ChiragCR13/Open-Loop-Boost-Converter/LTSpice/BoostConverter.asc

A1: schmitt; vt=4.5 vh=2.0 vhigh=9 vlow=0
C1: cap; 2.2n
C2: cap; 2.2n
C3: cap; 220µ; Rser=0.5
D1: schottky; 1N5819
L1: ind; 100µ; Rser=0.8
Q1: npn; BC547B
Q2: npn; BC547B
Q3: npn; 2N2222
R1: res; 1k
R2: res; 10k; tol=0
R3: res; 3.9k; tol=0
R4: res; 1k
R5: res; 330
R6: res; 1k
V1: voltage; 9; Rser=0
V2: voltage; 1.5; Rser=0
Named nets: 0
.tran 0 10 0 startup
.meas TRAN MyFreq FREQ V(n002) FROM 2m TO 5m
